Bhalddin/melzi/README

Melzi Ardentissimo
Based on Sanguinololu

Schematic and board files.

http://reprap.org/wiki/Melzi
