Bhalddin/melzi/melzi-board.png

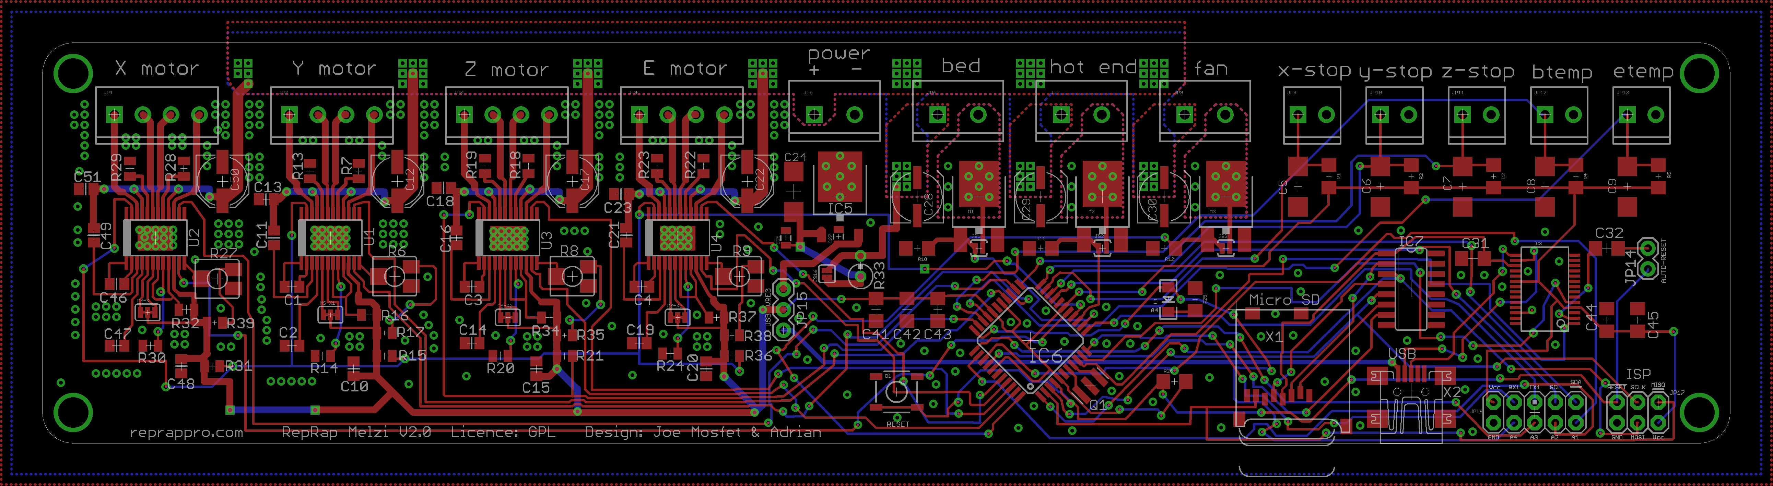
melzi-board.png
