Bhalddin/melzi/melzi.png

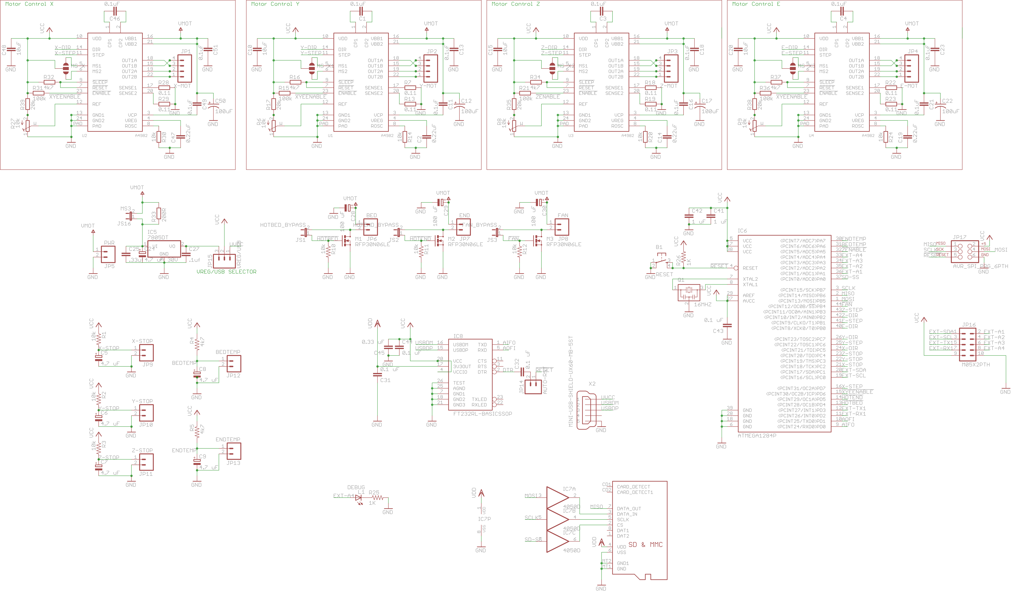
melzi.png
