Bhalddin/melzi/(commit log)

2012-06-16 Started replacing stepper driver chips.
    [melzi.brd, melzi.sch]
2012-06-16 Melzi update wip
    [melzi.sch]
2012-06-17 New stepper drivers - X axis done.
    [melzi.brd]
2012-06-25 Y and Z drives added.
    [melzi.brd]
2012-06-26 Pretty much finalised. A couple of unrouted grounds need to be fixed.
    [melzi.brd, melzi.sch]
2012-06-26 Melzi 2.0 finished (e&oe...)
    [melzi.brd, melzi.sch]
2012-06-27 Thermistor resistors changed to 4K7.
    [melzi.brd, melzi.sch]
2012-06-27 Gerbers and BOM added.
    [melzi-bom.csv, melzi-bom.ods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]
2012-06-28 Gaps between ground plane and tracks upped to 10 thou.
    [melzi.brd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]
2012-06-30 Made motor current pots turn the right way.
    [melzi.brd, melzi.sch]
2012-07-02 Gerbers for correct pot layout.
    [melzi.brd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]
2012-07-02 Extensive rerouting to give 10 thou clearance between tracks.
    [melzi.brd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]
2012-07-05 5V input solder link fixed.
    [melzi.brd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]
2012-07-10 Component IDs better positioned on silkscreen.
    [melzi.brd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]
2012-07-26 Added 0.33uF upstream of 5V reg. Specified 4.7uF cap in parallel as 30V.
    [melzi-bom.csv, melzi-bom.ods, melzi.brd, melzi.sch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]
2013-01-03 "Made in the UK" added to silkscreen.
    [melzi.brd, melzi.sch, melzi_.sch]
2013-01-03 New silkscreen gerber.
    [melzi.GTO]
2013-05-20 Correct resonator put in BoM.
    [melzi-bom.ods]
