Bhalddin/melzi/(notices)

Notices in the files:
melzi.brd:
reprappro.com RepRap Melzi V2.0 Licence: GPL Design: Joe Mosfet & Adrian
